maivananh111/DoAnTotNghiep/Node_Analog/bom/BOM_ANA.xlsx

null | References | Value | Footprint | Quantity
1 | C1, C3, C5, C11, C15, C20, C21, C22, C23, C24, C25, C28, C29, C33, C35 | 100nF | C_0603 | 15
2 | C2, C4, C8, C9, C16, C30, C31, C32, C37, C38 | 1uF | C_0603 | 10
3 | C10, C12, C13, C14, C17, C18, C34, C39, C40 | 10uF | C_0603 | 9
4 | C26, C27 | 10pF | C_0603 | 2
5 | C6 | 470uF/50V | CP_Elec_8x10.5 | 1
6 | C7 | 100uF | CP_Elec_6.3x7.7 | 1
7 | R1, R4, R24, R30, R34, R40, R44 | 10R | R_0603 | 7
8 | R3, R19, R25, R26, R27, R31, R48 | 20K | R_0603 | 7
9 | R5, R13, R32, R33, R41, R42 | 10K | R_0603 | 6
10 | R7, R12, R20, R21, R22 | 1K | R_0603 | 5
11 | R2, R18, R38, R46 | 100K | R_0603 | 4
12 | R28, R29, R43 | 5K1 | R_0603 | 3
13 | R14, R15 | 1K2 | R_0603 | 2
14 | R16, R37 | 100R | R_0603 | 2
15 | R17, R45 | 560K | R_0603 | 2
16 | R39, R49 | 2K7 | R_0603 | 2
17 | R47, R50 | 0R | R_0603 | 2
18 | R6 | 24K | R_0603 | 1
19 | R8 | 100R/1uF | R_0805 | 1
20 | R9 | 1K/33K | R_0603 | 1
21 | R10 | 100R/220R | R_0603 | 1
22 | R11 | 24K/8K2 | R_0603 | 1
23 | R23 | 39K | R_0603 | 1
24 | R35 | 1K/51R | R_0603 | 1
25 | R36 | 82K | R_0603 | 1
26 | L3, L5 | 22uH | L_Bourns_SRN6045TA | 2
27 | L1 | 68uH | L_12x12mm_H8mm | 1
28 | L2 | 2.2uH | L_Bourns_SRN6045TA | 1
29 | L4 | 2.2nH | L_0603 | 1
30 | D2, D5, D6 | SS34 | D_SMA | 3
31 | D1 | Z3V3 | D_MiniMELF | 1
32 | D3 | LED_Dual_AKAK | LED_HOUSING_LH32K051F | 1
33 | D4 | Z12V | D_MiniMELF | 1
34 | U6, U14 | MT3608 | SOT23-6 | 2
35 | U1 | RAK3172 | RAK3172 | 1
36 | U2 | LM358 | SOIC-8 | 1
37 | U3 | BQ24075RGT | VQFN-16_3x3_PAD-VIAS | 1
38 | U4 | XL1509-5.0 | SOIC-8 | 1
39 | U5 | TPS63000 | DRC-0010J | 1
40 | U9 | ESP32-C3 | QFN-32_5x5_PAD-VIAS | 1
41 | U10 | USBLC6-2SC6 | SOT23-6 | 1
42 | U11 | TL431DBZ | SOT23-3 | 1
43 | Y1 | 40MHz | Crystal_3225_4P_1-4 | 1
44 | SW1 | RAK-RESET | Switch_Tactile_6x6_Horizontal | 1
45 | SW2 | ESP-RESET | SW_SPST_CK | 1
46 | SW3 | ESP-BOOT | SW_SPST_CK | 1
47 | SW4 | USER_BTN | Switch_Tactile_6x6_Horizontal | 1
48 | Q1, Q4, Q6 | SI2300 | SOT23-3 | 3
49 | Q2, Q5, Q7 | SI2301 | SOT23-3 | 3
50 | RV1, RV2 | 10K | Potentiometer_Bourns_3296W_Vertical | 2
51 | AE1 | 2.4GHz | Texas_SWRA117D_2.4GHz_Right | 1
52 | BT2 | Battery_18650 | XH_2P_2.54mm_Vertical | 1
53 | Q3 | APM4015P | TO-252-2 | 1
54 | J1 | RAK_DEBUG | PinHeader_2x04_P2.54mm_Vertical | 1
55 | J2 | CONN_ANALOG | PhoenixContact_MC_1,5_4-G-3.81_1x04_P3.81mm_Horizontal | 1
56 | J3 | CONN_PWRIN | PhoenixContact_MC_1,5_2-G-3.81_1x02_P3.81mm_Horizontal | 1
57 | J4 | CONN_ESP_PROG | XH_6P_2.54mm_Vertical | 1
58 | J5 | USB_C_Receptacle_USB2.0_16P | USB-C_SMD_1 | 1
