maivananh111/DoAnTotNghiep/Node_RS485/bom/BOM.xlsx

null | Value | Footprint | Quantity | Link | Quantity 8pcs | Đã có
1 | 100nF | C_0603 | 11 | https://www.thegioiic.com/tu-gom-0603-100nf-0-1uf-50v | 120
2 | 1uF | C_0603 | 10 | https://www.thegioiic.com/tu-gom-0603-1uf-50v | 100
3 | 10uF | C_0603 | 6 | https://www.thegioiic.com/tu-gom-0603-10uf-25v | 60
4 | DNP | C_0603 | 2 | https://www.thegioiic.com/tu-gom-0603-3-3pf-50v | 20
5 | 10pF | C_0603 | 2 | https://www.thegioiic.com/tu-gom-0603-10pf-50v | 20
6 | 470uF/50V | CP_Elec_8x10.5 | 1 | https://www.thegioiic.com/tu-nhom-smd-470uf-16v-8x10-5mm | 8 | 4
7 | 100uF | C_Elec_6.3x7.7 | 1 | https://www.thegioiic.com/tu-nhom-smd-100uf-25v-6-3x7-7mm | 8 | 4
8 | 10R | R_0603 | 11 | https://www.thegioiic.com/dien-tro-10-ohm-0603-1- | 100
9 | 20K | R_0603 | 8 | https://www.thegioiic.com/dien-tro-20-kohm-0603-1- | 100
10 | 100K | R_0603 | 5 | https://www.thegioiic.com/dien-tro-100-kohm-0603-1- | 50
11 | 4K7 | R_0603 | 3 | https://www.thegioiic.com/dien-tro-4-7-kohm-0603-1- | 50
12 | 1K | R_0603 | 3 | https://www.thegioiic.com/dien-tro-1-kohm-0603-1- | 50
13 | 1K2 | R_0603 | 2 | https://www.thegioiic.com/dien-tro-1-2-kohm-0603-1- | 50
14 | 560K | R_0603 | 2 | https://www.thegioiic.com/dien-tro-560-kohm-0603-1- | 50
15 | 0R | R_0603 | 2 | https://www.thegioiic.com/dien-tro-0-ohm-0603-1- | 50
16 | 5K1 | R_0603 | 2 | https://www.thegioiic.com/dien-tro-5-6-kohm-0603-1- | 50
17 | 120R | R_0603 | 1 | https://www.thegioiic.com/dien-tro-120-ohm-0603-1- | 50
18 | 10K | R_0603 | 1 | https://www.thegioiic.com/dien-tro-10-kohm-0603-1- | 50
19 | 100R | R_0603 | 1 | https://www.thegioiic.com/dien-tro-100-ohm-0603-1- | 50
20 | 33K | R_0603 | 1 | https://www.thegioiic.com/dien-tro-3-3-kohm-0603-1- | 50
21 | 2K7 | R_0603 | 1 | https://www.thegioiic.com/dien-tro-2-7-kohm-0603-5- | 50
22 | 68uH | L_12x12mm_H8mm | 1 | https://www.thegioiic.com/cdrh127-cuon-cam-dan-smd-1280-680-68uh-3-2a | 8 | 4
23 | 2.2uH | L_Bourns_SRN6045TA | 1 | https://www.thegioiic.com/cuon-cam-dan-smd-cd53-5852-2r2-2-2uh-3-5a | 10
24 | 2.2nH | L_0603 | 1 | https://www.thegioiic.com/vhf160808h2n2st-cuon-cam-2-2nh-0603-1a | 10
25 | 22uH | L_Bourns_SRN6045TA | 1 | https://www.thegioiic.com/cuon-cam-dan-smd-cd53-5852-220-22uh-1-5a | 10
26 | SMAJ5.0CA | D_SMA_TVS | 3 |  | 8
27 | SS34 | D_SMA | 2 | https://www.thegioiic.com/twgmc-ss34-sma-diode-schottky-3a | 20
28 | Z12V | D_MiniMELF | 1 | https://www.thegioiic.com/zmm12-diode-zener-12v-500mw-smd | 10
29 | LED_Dual_AKAK | LED_HOUSING_LH32K051F | 1 | https://www.thegioiic.com/bo-chi-thi-2-led-xanh-duong-3mm-de-nhua-han-pcb | 8
30 | RAK3172 | RAK3172 | 1 |  | 8
31 | MAX3485EN | SOIC-8 | 1 | https://www.thegioiic.com/max3485ed-ic-transceiver-half-duplex-sop-8 | 2 | 2
32 | BQ24075RGT | VQFN-16_3x3_PAD-VIAS | 1 |  | 8
33 | XL1509-5.0 | SOIC-8 | 1 | https://www.thegioiic.com/xl1509-5-0e1-ic-on-ap-5v-2a-8-soic | 8 | 4
34 | TPS63000 | DRC-0010J | 1 |  | 8
35 | ESP32-C3 | QFN-32_5x5_PAD-VIAS | 1 |  | 8
36 | USBLC6-2SC6 | SOT23-6 | 1 | https://icdayroi.com/usblc6-2sc6-tvs-diode-5-25v-17v-sot23-6 | 8 | 4
37 | MT3608 | SOT23-6 | 1 | https://www.thegioiic.com/mt3608-ic-dieu-chinh-tang-ap-2a-sot-23-6 | 10 | 4
38 | 40MHz | Crystal_3225_4P_1-4 | 1 | https://www.thegioiic.com/thach-anh-40mhz-3225-4-chan-smd | 8 | 4
39 | Fuse | F_1812 | 2 | https://www.thegioiic.com/mf-msmf050-2-cau-chi-tu-phuc-hoi-1812-15v-0-5a | 4
40 | RAK-RESET | Switch_Tactile_6x6_Horizontal | 1 | https://www.thegioiic.com/nut-nhan-6x6mm-cao-5mm-4-chan-xuyen-lo-chinh-ngang | 8
41 | ESP-RESET | SW_SPST_CK | 1 | https://www.thegioiic.com/nut-nhan-3x6mm-cao-2-5mm-2-chan-smd-dau-do | 8
42 | ESP-BOOT | SW_SPST_CK | 1 | https://www.thegioiic.com/nut-nhan-3x6mm-cao-2-5mm-2-chan-smd-dau-do | 8
43 | MODE_SEL_BTN | Switch_Tactile_6x6_Horizontal | 1 | https://www.thegioiic.com/nut-nhan-6x6mm-cao-5mm-4-chan-xuyen-lo-chinh-ngang | 8
44 | SI2300 | SOT23-3 | 3 | https://www.thegioiic.com/si2300ds-mosfet-kenh-n-30v-3-6a-sot-23 | 30
45 | SI2301 | SOT23-3 | 3 | https://www.thegioiic.com/si2301ds-mosfet-kenh-p | 30
46 | 2.4GHz | Texas_SWRA117D_2.4GHz_Right | 1 |  | 0
47 | Battery_18650 | XH_2P_2.54mm_Vertical | 1 | https://www.thegioiic.com/day-bus-xh2-54-1-dau-cai-2-tiep-diem-2-54mm-dai-20cm | 8
48 | APM4015P | TO-252-2 | 1 | https://www.thegioiic.com/apm4015p-mosfet-kenh-p-40v-45a-to-252 | 8 | 4
49 | RAK_DEBUG | PinHeader_2x04_P2.54mm_Vertical | 1 | https://www.thegioiic.com/hang-rao-duc-doi-2-54mm-80-chan-cong-2-hang-xuyen-lo | 2
50 | CONN_RS485 | PhoenixContact_MC_1,5_4-G-3.81_1x04_P3.81mm_Horizontal | 1 | https://www.thegioiic.com/kf-3-81-4-r-terminal-block-plug-in-han-pcb-4-chan-cong-3-81mm-300v-10a | 10
51 | CONN_PWRIN | PhoenixContact_MC_1,5_2-G-3.81_1x02_P3.81mm_Horizontal | 1 | https://www.thegioiic.com/kf-3-81-2-r-terminal-block-plug-in-han-pcb-2-chan-cong-3-81mm-300v-10a | 10
52 | CONN_ESP_PROG | XH_6P_2.54mm_Vertical | 1 | https://www.thegioiic.com/dau-xhb-6a-2-54mm-6-chan-thang-xuyen-lo | 10
53 | USB_C_Receptacle_USB2.0_16P | USB-C_SMD_1 | 1 | https://www.thegioiic.com/cong-usb-cai-3-1-type-c-16-chan-thang-dan-smd | 8
54 | MAX3232 | SOIC-16-4x10-P1.27 | 1 | https://www.thegioiic.com/max3232ese-umw-ic-transceiver-full-2-2-16-sop | 2 | 2
 | 24K | R_0603 | 1 | https://www.thegioiic.com/dien-tro-24-kohm-0603-5- | 50
 | 33K | R_0603 | 1 | https://www.thegioiic.com/dien-tro-33-kohm-0603-1- | 50
 | 220R | R_0603 | 1 | https://www.thegioiic.com/dien-tro-220-ohm-0603-1- | 50
 | 8K2 | R_0603 | 1 | https://www.thegioiic.com/dien-tro-8-2-kohm-0603-1- | 50
 | 39K | R_0603 | 1 | https://www.thegioiic.com/dien-tro-39-kohm-0603-1- | 50
 | 51R | R_0603 | 1 | https://www.thegioiic.com/dien-tro-51-ohm-0603-5- | 50
 | 82K | R_0603 | 1 | https://www.thegioiic.com/dien-tro-82-kohm-0603-1- | 50
 | Z3V3 | D_MiniMELF | 1 | https://www.thegioiic.com/zmm3v3-diode-zener-3-3v-500mw-smd | 5
 | MCP6002 | SOIC-8 | 1 | https://www.thegioiic.com/mcp6002-i-sn-ic-opamp-general-purpose-amplifier-2-circuit-1mhz-8-soic | 2 | 2
 | TL431DBZ | SOT23-3 | 1 | https://www.thegioiic.com/tl431-ic-tham-chieu-dien-ap-2-5-36v-sot-23 | 2
 | LED đỏ 3mm |  | 1 | https://www.thegioiic.com/led-do-3mm-chan-dai | 10
 | 100R | R_0805 | 1 | https://www.thegioiic.com/dien-tro-100-ohm-0805-1- | 50
 | Ipex to SMA cái |  | 1 | https://www.thegioiic.com/cap-rf-dau-sma-cai-noi-1-13ipex-dai-10cm | 8 | 5
 | Thiếc hàn |  | 2 | https://www.thegioiic.com/thiec-han-0-8-sn63-pb37-16g-a-chau | 2
