maivananh111/DoAnTotNghiep/HoaDonTGIC.pdf

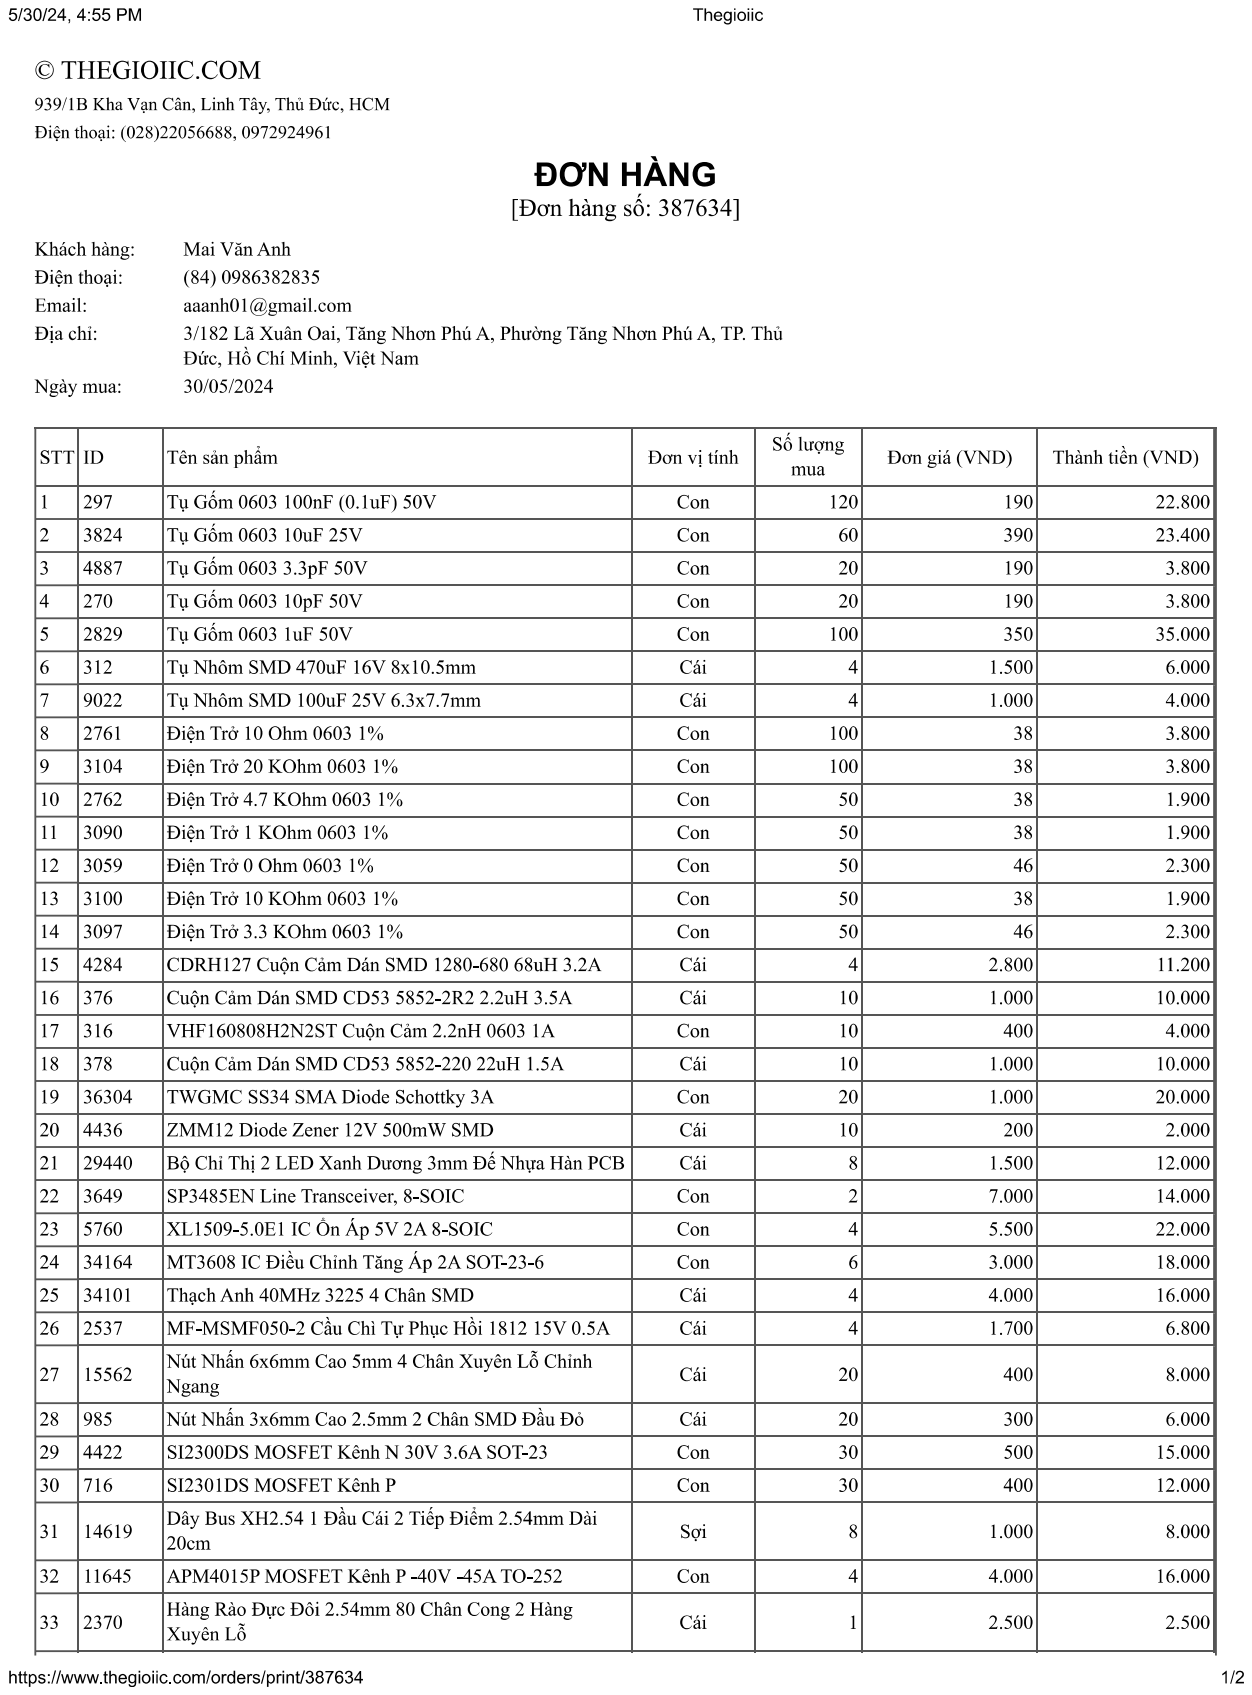
[picture p1: page 1]

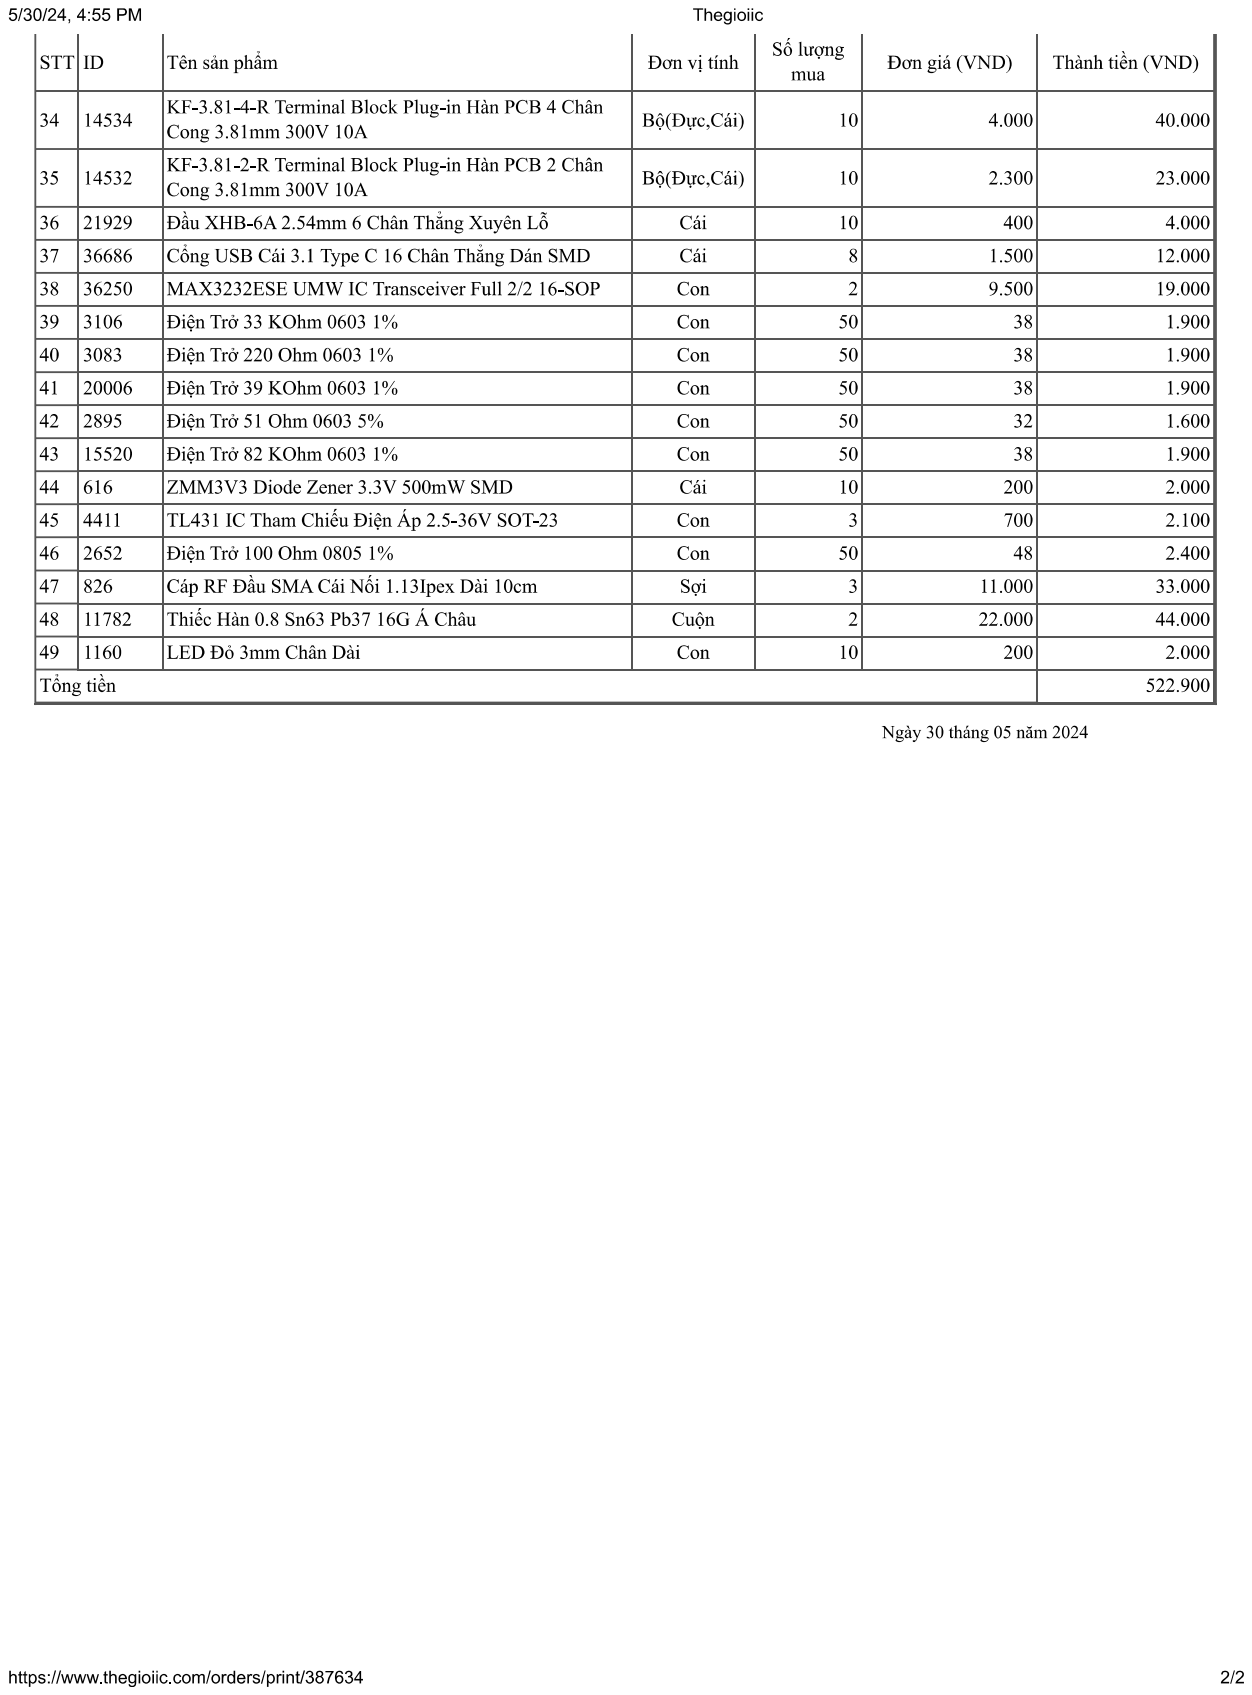
[picture p2: page 2]
