maivananh111/DoAnTotNghiep/Node_Analog/Node_Analog.kicad_pcb

## KiCad design Node_Analog/Node_Analog.kicad_pcb (2024-06-06)

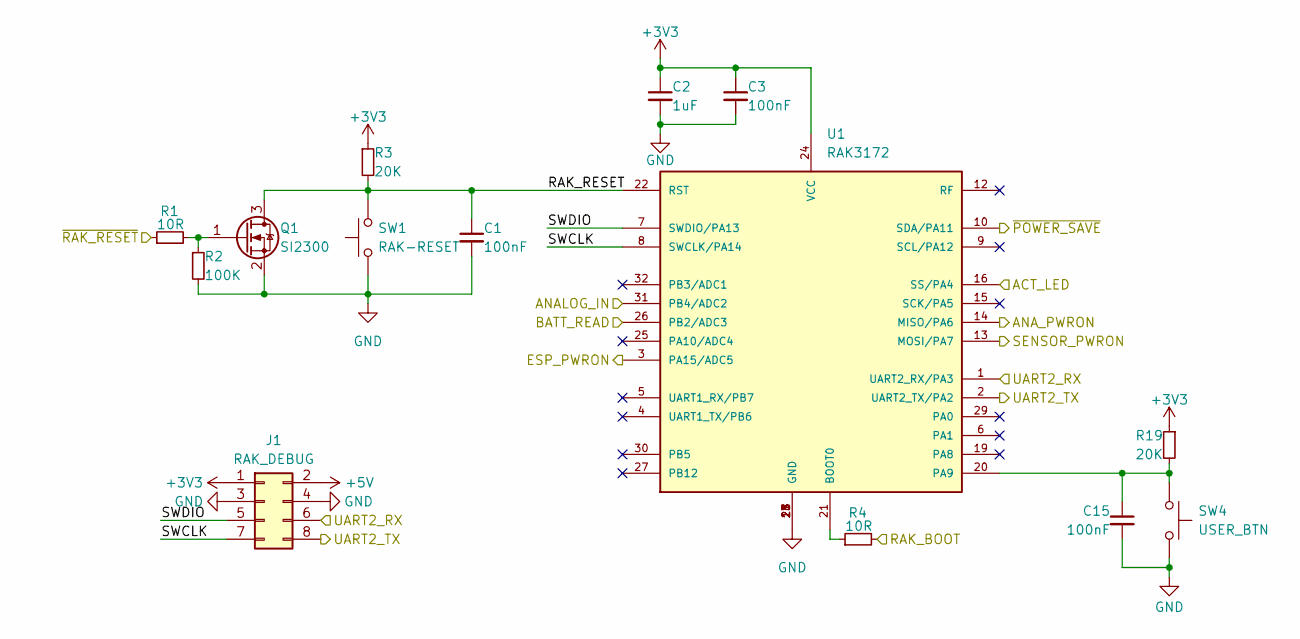
[picture p3: schematic RAK3172_LoRa.kicad_sch]

Parts:
C1, C3, C15: 100nF; C_0603
C2: 1uF; C_0603
J1: RAK_DEBUG; PinHeader_2x04_P2.54mm_Vertical
Q1: SI2300; SOT23-3
R1, R4: 10R; R_0603
R2: 100K; R_0603
R3, R19: 20K; R_0603
SW1: RAK-RESET; Switch_Tactile_6x6_Horizontal
SW4: USER_BTN; Switch_Tactile_6x6_Horizontal
U1: RAK3172

Connections:
+3V3: C2.1, C3.1, J1.1, R3.1, R19.1, U1.24 (VCC); also elsewhere on the board
+5V: J1.2; also elsewhere on the board
/Analog/ANALOG_OUT: U1.31 (PB4/ADC2); also elsewhere on the board
/ESP32-C3_BLE/ESP_PWRON: U1.3 (PA15/ADC5); also elsewhere on the board
/ESP32-C3_BLE/OTA_BOOT: R4.2; also elsewhere on the board
/ESP32-C3_BLE/OTA_RST: R1.1; also elsewhere on the board
/ESP32-C3_BLE/UART1_RX: J1.8, U1.2 (UART2_TX/PA2); also elsewhere on the board
/ESP32-C3_BLE/UART1_TX: J1.6, U1.1 (UART2_RX/PA3); also elsewhere on the board
/PSU/5V_EN: U1.13 (MOSI/PA7); also elsewhere on the board
/PSU/24V_EN: U1.14 (MISO/PA6); also elsewhere on the board
/PSU/ACT_LED: U1.16 (SS/PA4); also elsewhere on the board
/PSU/VBAT_MONITOR: U1.26 (PB2/ADC3); also elsewhere on the board
/PSU/~POWER_SAVE: U1.10 (SDA/PA11); also elsewhere on the board
/RAK3172_LoRa/RAK_RESET: C1.1, Q1.3 (D), R3.2, SW1.2, U1.22 (RST)
/RAK3172_LoRa/SWCLK: J1.7, U1.8 (SWCLK/PA14)
/RAK3172_LoRa/SWDIO: J1.5, U1.7 (SWDIO/PA13)
GND: C1.2, C2.2, C3.2, C15.2, J1.3, J1.4, Q1.2 (S), R2.2, SW1.1, SW4.1, U1.11 (GND), U1.17 (GND), U1.18 (GND), U1.23 (GND), U1.28 (GND); also elsewhere on the board
unnamed: Q1.1 (G), R1.2, R2.1
unnamed: R4.1, U1.21 (BOOT0)
unnamed: C15.1, R19.2, SW4.2, U1.20 (PA9)

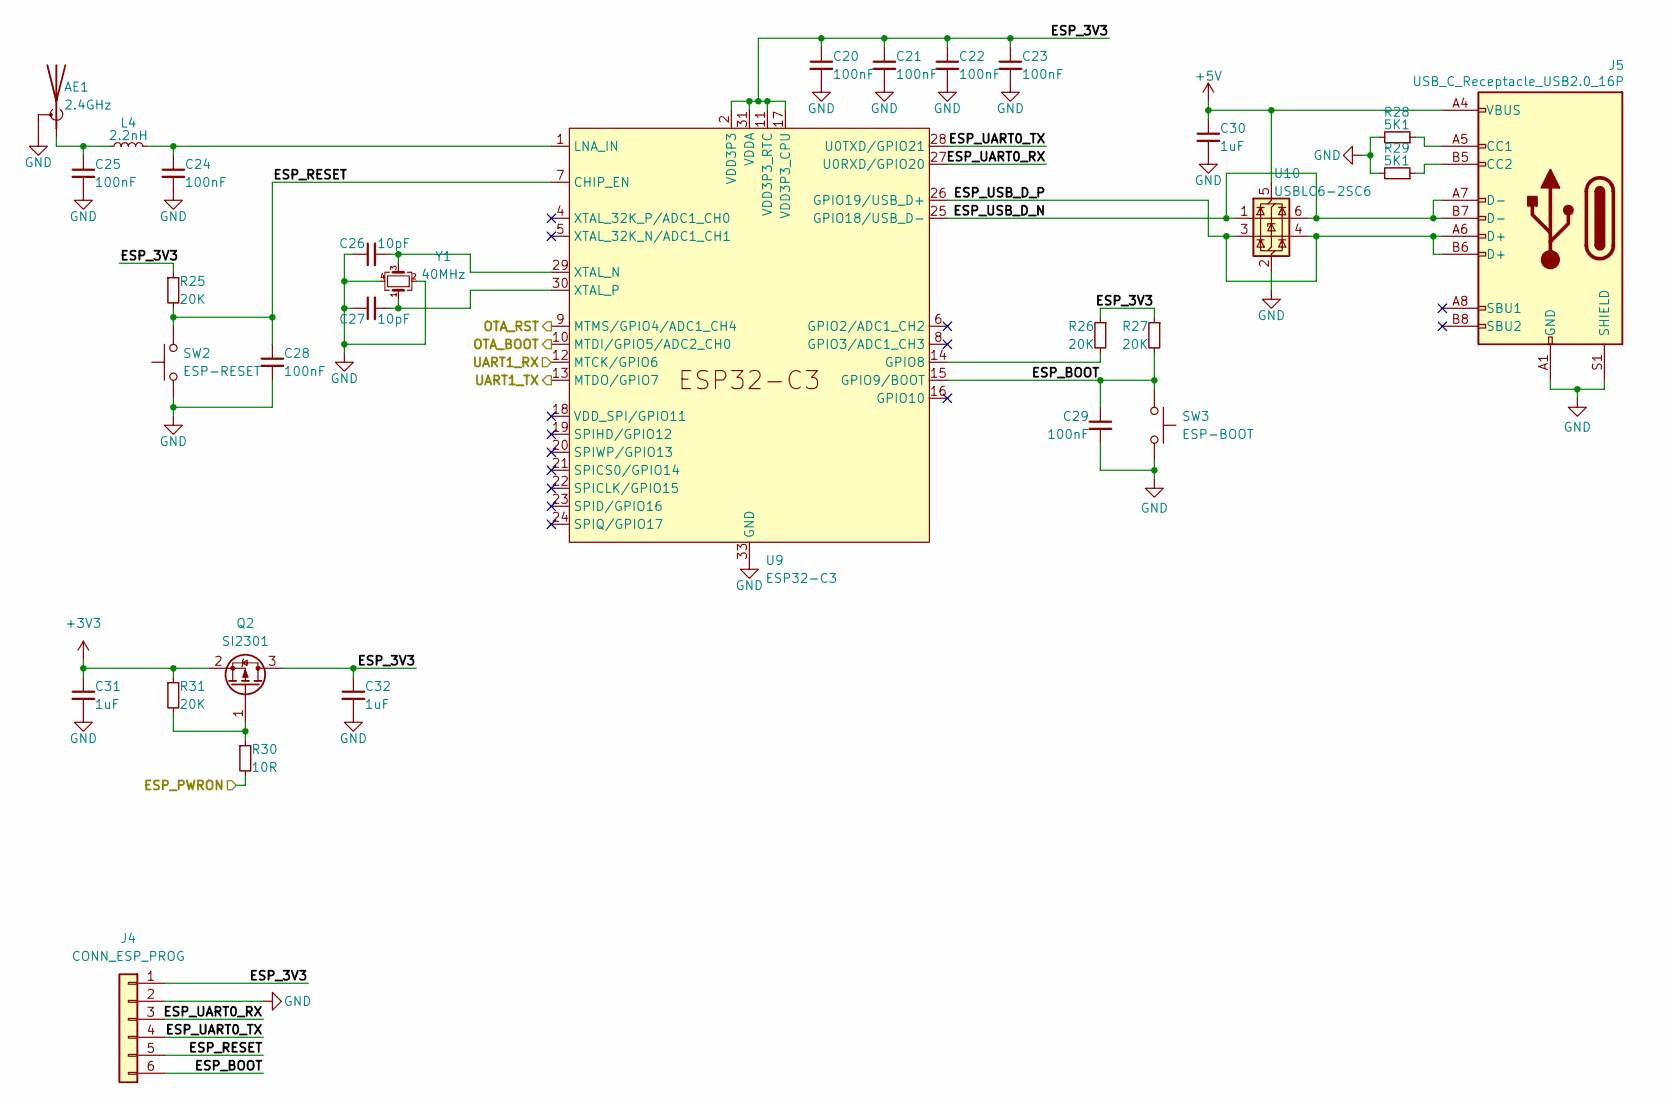
[picture p4: schematic ESP32-C3_BLE.kicad_sch]

Parts:
AE1: 2.4GHz; Texas_SWRA117D_2.4GHz_Right
C20, C21, C22, C23, C24, C25, C28, C29: 100nF; C_0603
C26, C27: 10pF; C_0603
C30, C31, C32: 1uF; C_0603
J4: CONN_ESP_PROG; XH_6P_2.54mm_Vertical
J5: USB_C_Receptacle_USB2.0_16P; USB-C_SMD_1
L4: 2.2nH; L_0603
Q2: SI2301; SOT23-3
R25, R26, R27, R31: 20K; R_0603
R28, R29: 5K1; R_0603
R30: 10R; R_0603
SW2: ESP-RESET; SW_SPST_CK
SW3: ESP-BOOT; SW_SPST_CK
U9: ESP32-C3; QFN-32_5x5_PAD-VIAS
U10: USBLC6-2SC6; SOT23-6
Y1: 40MHz; Crystal_3225_4P_1-4

Connections:
+3V3: C31.1, Q2.2 (S), R31.1; also elsewhere on the board
+5V: C30.1, J5.A4 (VBUS), J5.A9 (VBUS), J5.B4 (VBUS), J5.B9 (VBUS), U10.5 (VBUS); also elsewhere on the board
/ESP32-C3_BLE/ESP_3V3: C20.1, C21.1, C22.1, C23.1, C32.1, J4.1, Q2.3 (D), R25.1, R26.1, R27.1, U9.2 (VDD3P3), U9.3 (VDD3P3), U9.11 (VDD3P3_RTC), U9.17 (VDD3P3_CPU), U9.31 (VDDA), U9.32 (VDDA)
/ESP32-C3_BLE/ESP_BOOT: C29.1, J4.6, R27.2, SW3.2, U9.15 (GPIO9/BOOT)
/ESP32-C3_BLE/ESP_PWRON: R30.2; also elsewhere on the board
/ESP32-C3_BLE/ESP_RESET: C28.1, J4.5, R25.2, SW2.2, U9.7 (CHIP_EN)
/ESP32-C3_BLE/ESP_UART0_RX: J4.3, U9.27 (U0RXD/GPIO20)
/ESP32-C3_BLE/ESP_UART0_TX: J4.4, U9.28 (U0TXD/GPIO21)
/ESP32-C3_BLE/ESP_USB_D_N: J5.A7 (D-), J5.B7 (D-), U9.25 (GPIO18/USB_D-), U10.1 (I/O1), U10.6 (I/O1)
/ESP32-C3_BLE/ESP_USB_D_P: J5.A6 (D+), J5.B6 (D+), U9.26 (GPIO19/USB_D+), U10.3 (I/O2), U10.4 (I/O2)
/ESP32-C3_BLE/OTA_BOOT: U9.10 (MTDI/GPIO5/ADC2_CH0); also elsewhere on the board
/ESP32-C3_BLE/OTA_RST: U9.9 (MTMS/GPIO4/ADC1_CH4); also elsewhere on the board
/ESP32-C3_BLE/UART1_RX: U9.12 (MTCK/GPIO6); also elsewhere on the board
/ESP32-C3_BLE/UART1_TX: U9.13 (MTDO/GPIO7); also elsewhere on the board
GND: AE1.2 (Shield), C20.2, C21.2, C22.2, C23.2, C24.2, C25.2, C26.1, C27.1, C28.2, C29.2, C30.2, C31.2, C32.2, J4.2, J5.A1 (GND), J5.A12 (GND), J5.B1 (GND), J5.B12 (GND), J5.S1 (SHIELD), R28.2, R29.2, SW2.1, SW3.1, U9.33 (GND), U10.2 (GND), Y1.2, Y1.4; also elsewhere on the board
unnamed: AE1.1 (A), C25.1, L4.1
unnamed: J5.A5 (CC1), R28.1
unnamed: J5.B5 (CC2), R29.1
unnamed: Q2.1 (G), R30.1, R31.2
unnamed: R26.2, U9.14 (GPIO8)
unnamed: C24.1, L4.2, U9.1 (LNA_IN)
unnamed: C26.2, U9.29 (XTAL_N), Y1.3
unnamed: C27.2, U9.30 (XTAL_P), Y1.1

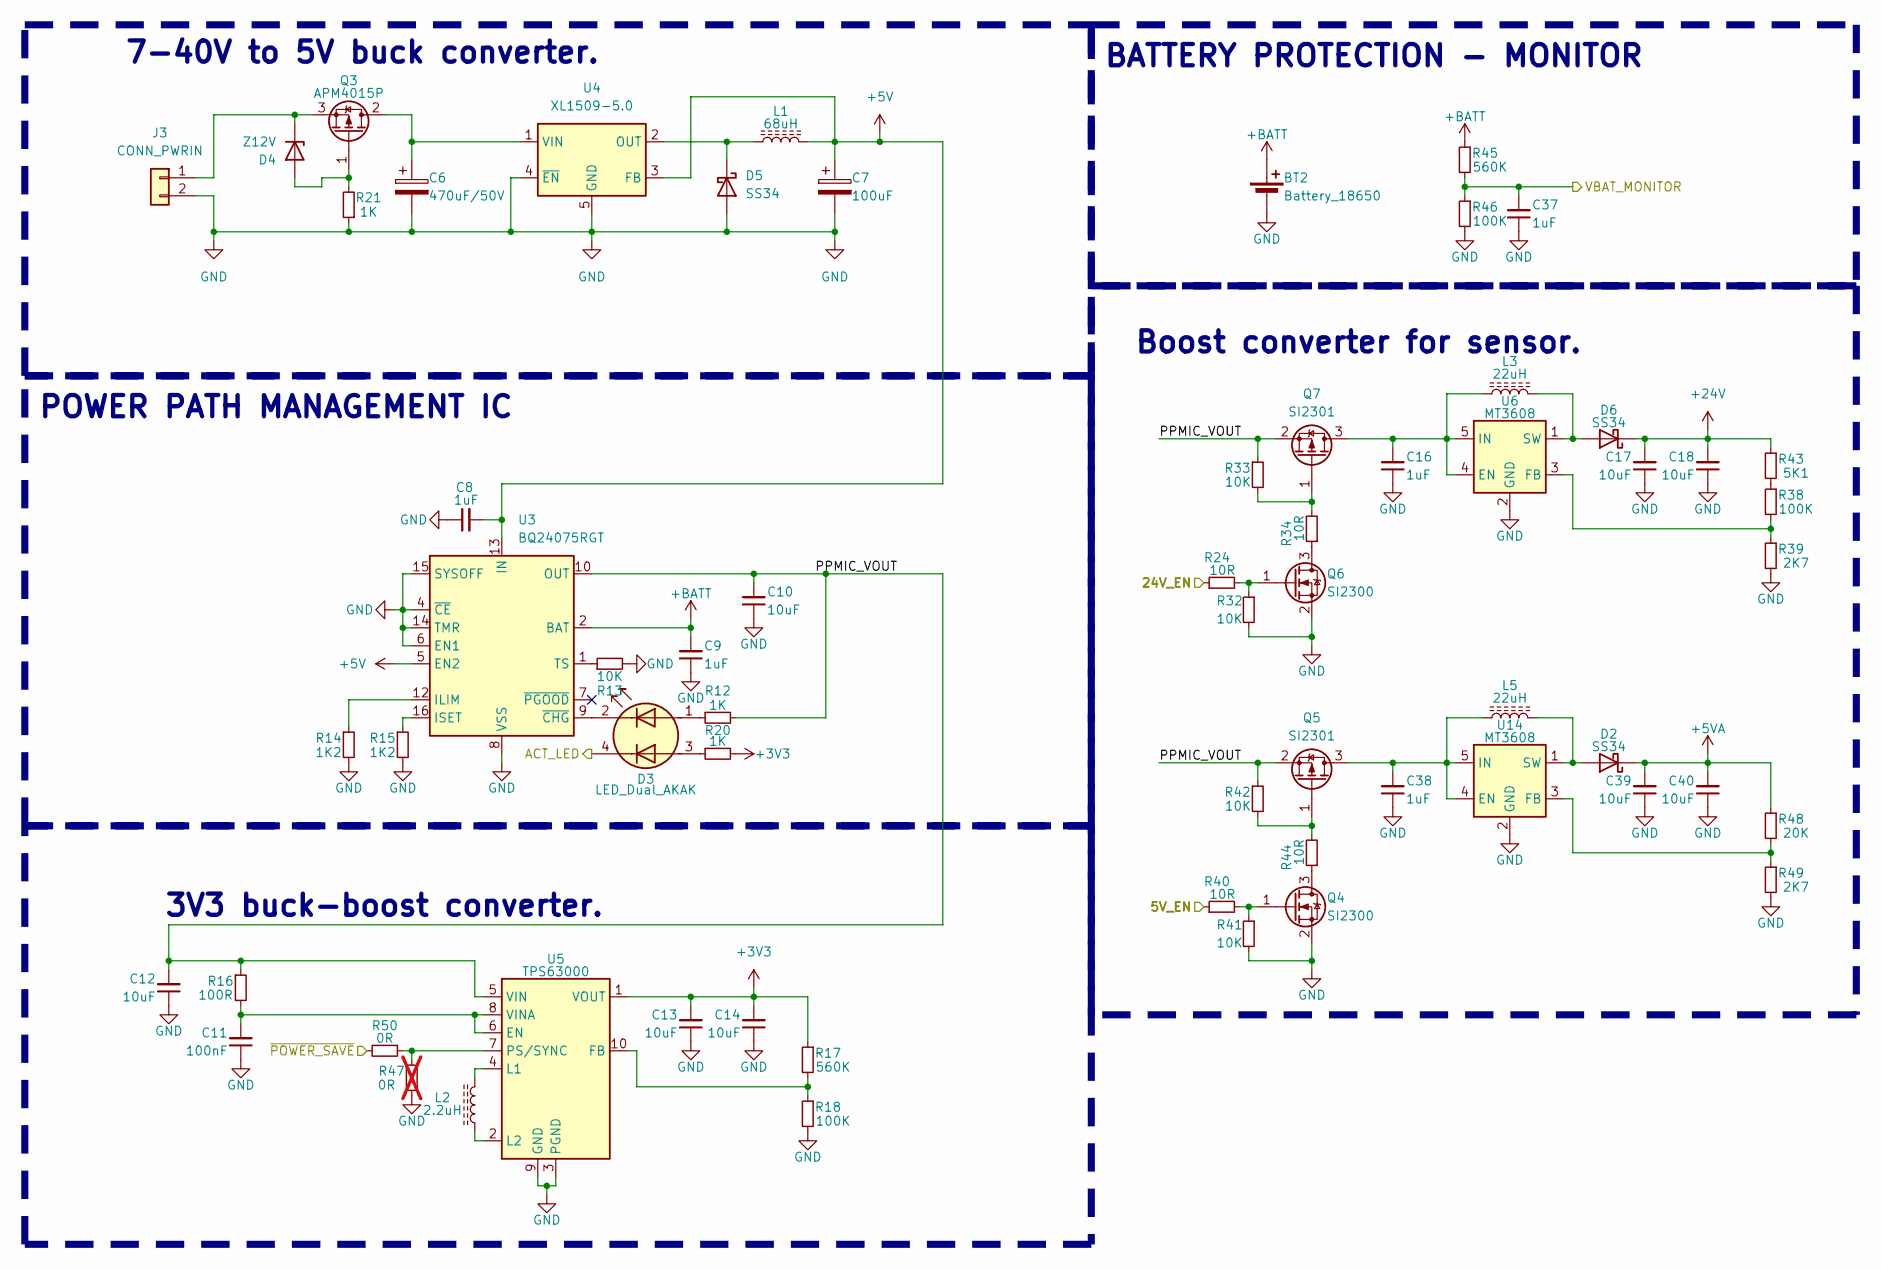
[picture p5: schematic PSU.kicad_sch]

Parts:
BT2: Battery_18650; XH_2P_2.54mm_Vertical
C6: 470uF/50V; CP_Elec_8x10.5
C7: 100uF; CP_Elec_6.3x7.7
C8, C9, C16, C37, C38: 1uF; C_0603
C10, C12, C13, C14, C17, C18, C39, C40: 10uF; C_0603
C11: 100nF; C_0603
D2, D5, D6: SS34; D_SMA
D3: LED_Dual_AKAK; LED_HOUSING_LH32K051F
D4: Z12V; D_MiniMELF
J3: CONN_PWRIN; PhoenixContact_MC_1,5_2-G-3.81_1x02_P3.81mm_Horizontal
L1: 68uH; L_12x12mm_H8mm
L2: 2.2uH; L_Bourns_SRN6045TA
L3, L5: 22uH; L_Bourns_SRN6045TA
Q3: APM4015P; TO-252-2
Q4, Q6: SI2300; SOT23-3
Q5, Q7: SI2301; SOT23-3
R12, R20, R21: 1K; R_0603
R13, R32, R33, R41, R42: 10K; R_0603
R14, R15: 1K2; R_0603
R16: 100R; R_0603
R17, R45: 560K; R_0603
R18, R38, R46: 100K; R_0603
R24, R34, R40, R44: 10R; R_0603
R39, R49: 2K7; R_0603
R43: 5K1; R_0603
R47: 0R; R_0603; not fitted
R48: 20K; R_0603
R50: 0R; R_0603
U3: BQ24075RGT; VQFN-16_3x3_PAD-VIAS
U4: XL1509-5.0; SOIC-8
U5: TPS63000; DRC-0010J
U6, U14: MT3608; SOT23-6

Connections:
+3V3: C13.2, C14.2, R17.1, R20.2, U5.1 (VOUT); also elsewhere on the board
+5V: C7.1, C8.2, L1.2, U3.5 (EN2), U3.13 (IN), U4.3 (FB); also elsewhere on the board
+5VA: C39.2, C40.2, D2.1 (K), R48.1; also elsewhere on the board
+24V: C17.2, C18.2, D6.1 (K), R43.1; also elsewhere on the board
+BATT: BT2.1 (+), C9.2, R45.1, U3.2 (BAT), U3.3 (BAT)
/PSU/5V_EN: R40.1; also elsewhere on the board
/PSU/24V_EN: R24.1; also elsewhere on the board
/PSU/ACT_LED: D3.4 (K2); also elsewhere on the board
/PSU/PPMIC_VOUT: C10.2, C12.2, Q5.2 (S), Q7.2 (S), R12.2, R16.1, R33.1, R42.1, U3.10 (OUT), U3.11 (OUT), U5.5 (VIN)
/PSU/VBAT_MONITOR: C37.2, R45.2, R46.1; also elsewhere on the board
/PSU/~POWER_SAVE: R50.2; also elsewhere on the board
GND: BT2.2 (-), C6.2, C7.2, C8.1, C9.1, C10.1, C11.1, C12.1, C13.1, C14.1, C16.1, C17.1, C18.1, C37.1, C38.1, C39.1, C40.1, D5.2 (A), J3.2, Q4.2 (S), Q6.2 (S), R13.2, R14.2, R15.2, R18.2, R21.1, R32.2, R39.2, R41.2, R46.2, R47.2, R49.2, U3.4 (~CE), U3.6 (EN1), U3.8 (VSS), U3.14 (TMR), U3.15 (SYSOFF), U3.17 (VSS), U4.4 (~EN), U4.5 (GND), U4.6 (GND), U4.7 (GND), U4.8 (GND), U5.3 (PGND), U5.9 (GND), U5.11 (PGND), U6.2 (GND), U14.2 (GND); also elsewhere on the board
unnamed: D2.2 (A), L5.2, U14.1 (SW)
unnamed: D3.1 (A1), R12.1
unnamed: D3.3 (A2), R20.1
unnamed: D3.2 (K1), U3.9 (~CHG)
unnamed: D4.2 (A), Q3.1 (G), R21.2
unnamed: D4.1 (K), J3.1, Q3.3 (S)
unnamed: D5.1 (K), L1.1, U4.2 (OUT)
unnamed: D6.2 (A), L3.2, U6.1 (SW)
unnamed: C6.1, Q3.2 (D), U4.1 (VIN)
unnamed: Q4.3 (D), R44.1
unnamed: Q4.1 (G), R40.2, R41.1
unnamed: C38.2, L5.1, Q5.3 (D), U14.4 (EN), U14.5 (IN)
unnamed: Q5.1 (G), R42.2, R44.2
unnamed: Q6.3 (D), R34.1
unnamed: Q6.1 (G), R24.2, R32.1
unnamed: C16.2, L3.1, Q7.3 (D), U6.4 (EN), U6.5 (IN)
unnamed: Q7.1 (G), R33.2, R34.2
unnamed: R38.1, R43.2
unnamed: R14.1, U3.12 (ILIM)
unnamed: R15.1, U3.16 (ISET)
unnamed: R13.1, U3.1 (TS)
unnamed: C11.2, R16.2, U5.6 (EN), U5.8 (VINA)
unnamed: R17.2, R18.1, U5.10 (FB)
unnamed: L2.2, U5.4 (L1)
unnamed: L2.1, U5.2 (L2)
unnamed: R47.1, R50.1, U5.7 (PS/SYNC)
unnamed: R38.2, R39.1, U6.3 (FB)
unnamed: R48.2, R49.1, U14.3 (FB)

Notes on the sheet:
3V3 buck-boost converter.
POWER PATH MANAGEMENT IC
BATTERY PROTECTION - MONITOR
7-40V to 5V buck converter.
Boost converter for sensor.

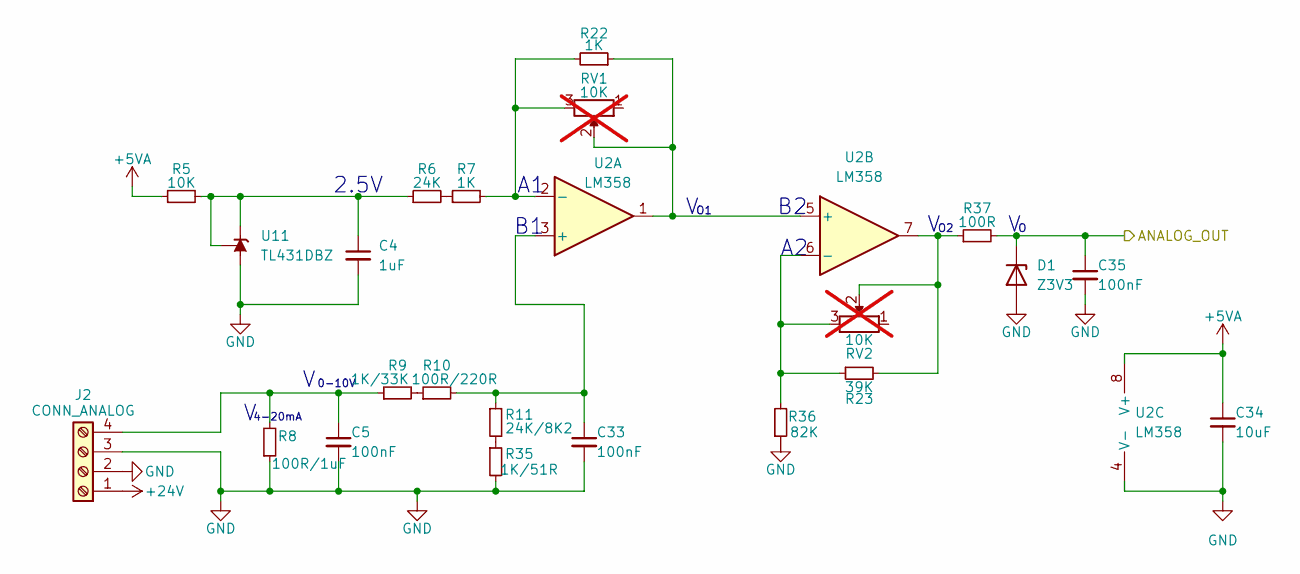
[picture p6: schematic Analog.kicad_sch]

Parts:
C4: 1uF; C_0603
C5, C33, C35: 100nF; C_0603
C34: 10uF; C_0603
D1: Z3V3; D_MiniMELF
J2: CONN_ANALOG; PhoenixContact_MC_1,5_4-G-3.81_1x04_P3.81mm_Horizontal
R5: 10K; R_0603
R6: 24K; R_0603
R7, R22: 1K; R_0603
R8: 100R/1uF; R_0805
R9: 1K/33K; R_0603
R10: 100R/220R; R_0603
R11: 24K/8K2; R_0603
R23: 39K; R_0603
R35: 1K/51R; R_0603
R36: 82K; R_0603
R37: 100R; R_0603
RV1, RV2: 10K; Potentiometer_Bourns_3296W_Vertical; not fitted
U2: LM358; SOIC-8
U11: TL431DBZ; SOT23-3

Connections:
+5VA: C34.1, R5.1, U2.8 (V+); also elsewhere on the board
+24V: J2.1; also elsewhere on the board
/Analog/ANALOG_OUT: C35.1, D1.1 (K), R37.2; also elsewhere on the board
GND: C4.2, C5.2, C33.2, C34.2, C35.2, D1.2 (A), J2.2, J2.3, R8.1, R35.2, R36.1, U2.4 (V-), U11.3 (A); also elsewhere on the board
unnamed: C5.1, J2.4, R8.2, R9.1
unnamed: R6.2, R7.1
unnamed: R9.2, R10.1
unnamed: R11.2, R35.1
unnamed: R23.2, R37.1, RV2.2, U2.7
unnamed: C33.1, R10.2, R11.1, U2.3 (+)
unnamed: R7.2, R22.2, RV1.3, U2.2 (-)
unnamed: R22.1, RV1.2, U2.1, U2.5 (+)
unnamed: R23.1, R36.2, RV2.3, U2.6 (-)
unnamed: C4.1, R5.2, R6.1, U11.1 (K), U11.2 (REF)

Notes on the sheet:
4-20mA
0-10V
2.5V

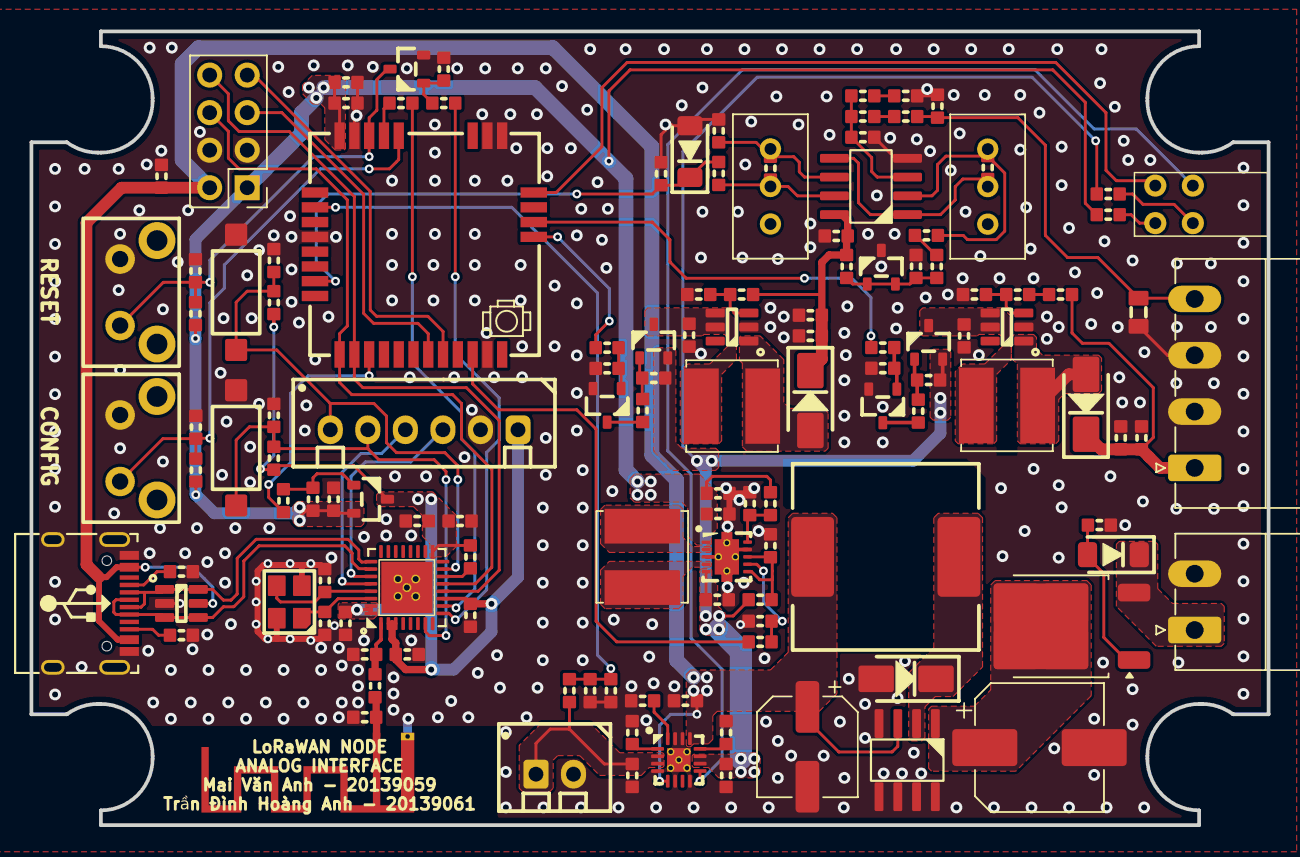
[picture p7: board Node_Analog.kicad_pcb from above]

Board: 2 copper layers, 83.7 x 53.7 mm, 131 parts (1 on the bottom side), 77 nets.

Other parts of the board:
 : LOGO; LoGo_IoTVision_25x6.5
