maivananh111/DoAnTotNghiep/(commit log)

2024-05-21 Hardware bug pin PB12
    [Analog.kicad_sch, BOM.csv, ESP32-C3_BLE.kicad_sch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]
2024-06-06 New version.
    [Analog.kicad_sch, BOM.xlsx, BOM_ANA.xlsx, BOM_RS232.xlsx, ESP32-C3_BLE.kicad_sch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]
